vitasam/AppleII-VGA/AppleVGA/AppleVGA.kicad_sch

## KiCad design AppleVGA/AppleVGA.kicad_sch (2024-08-16)

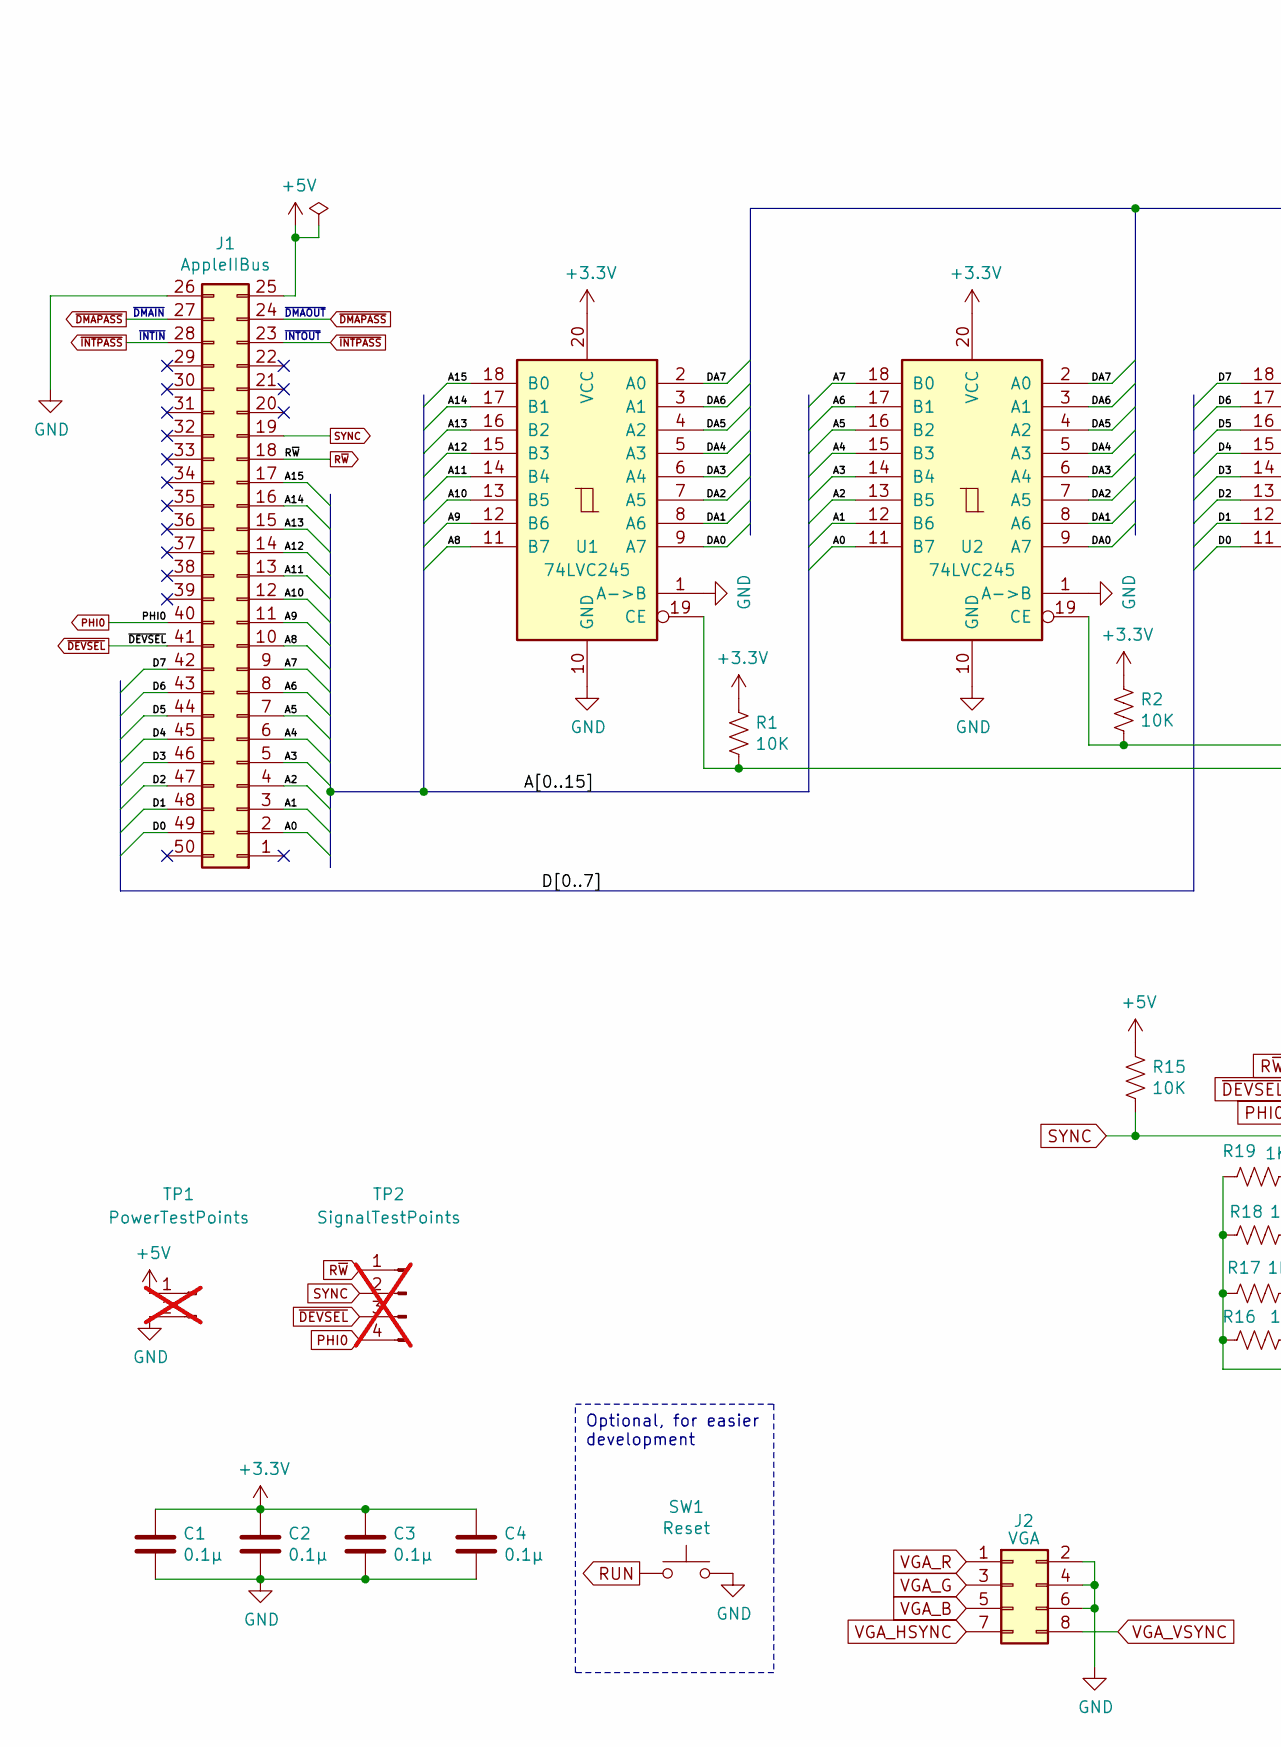
[picture p1: schematic AppleVGA.kicad_sch, part in row 1, column 1]

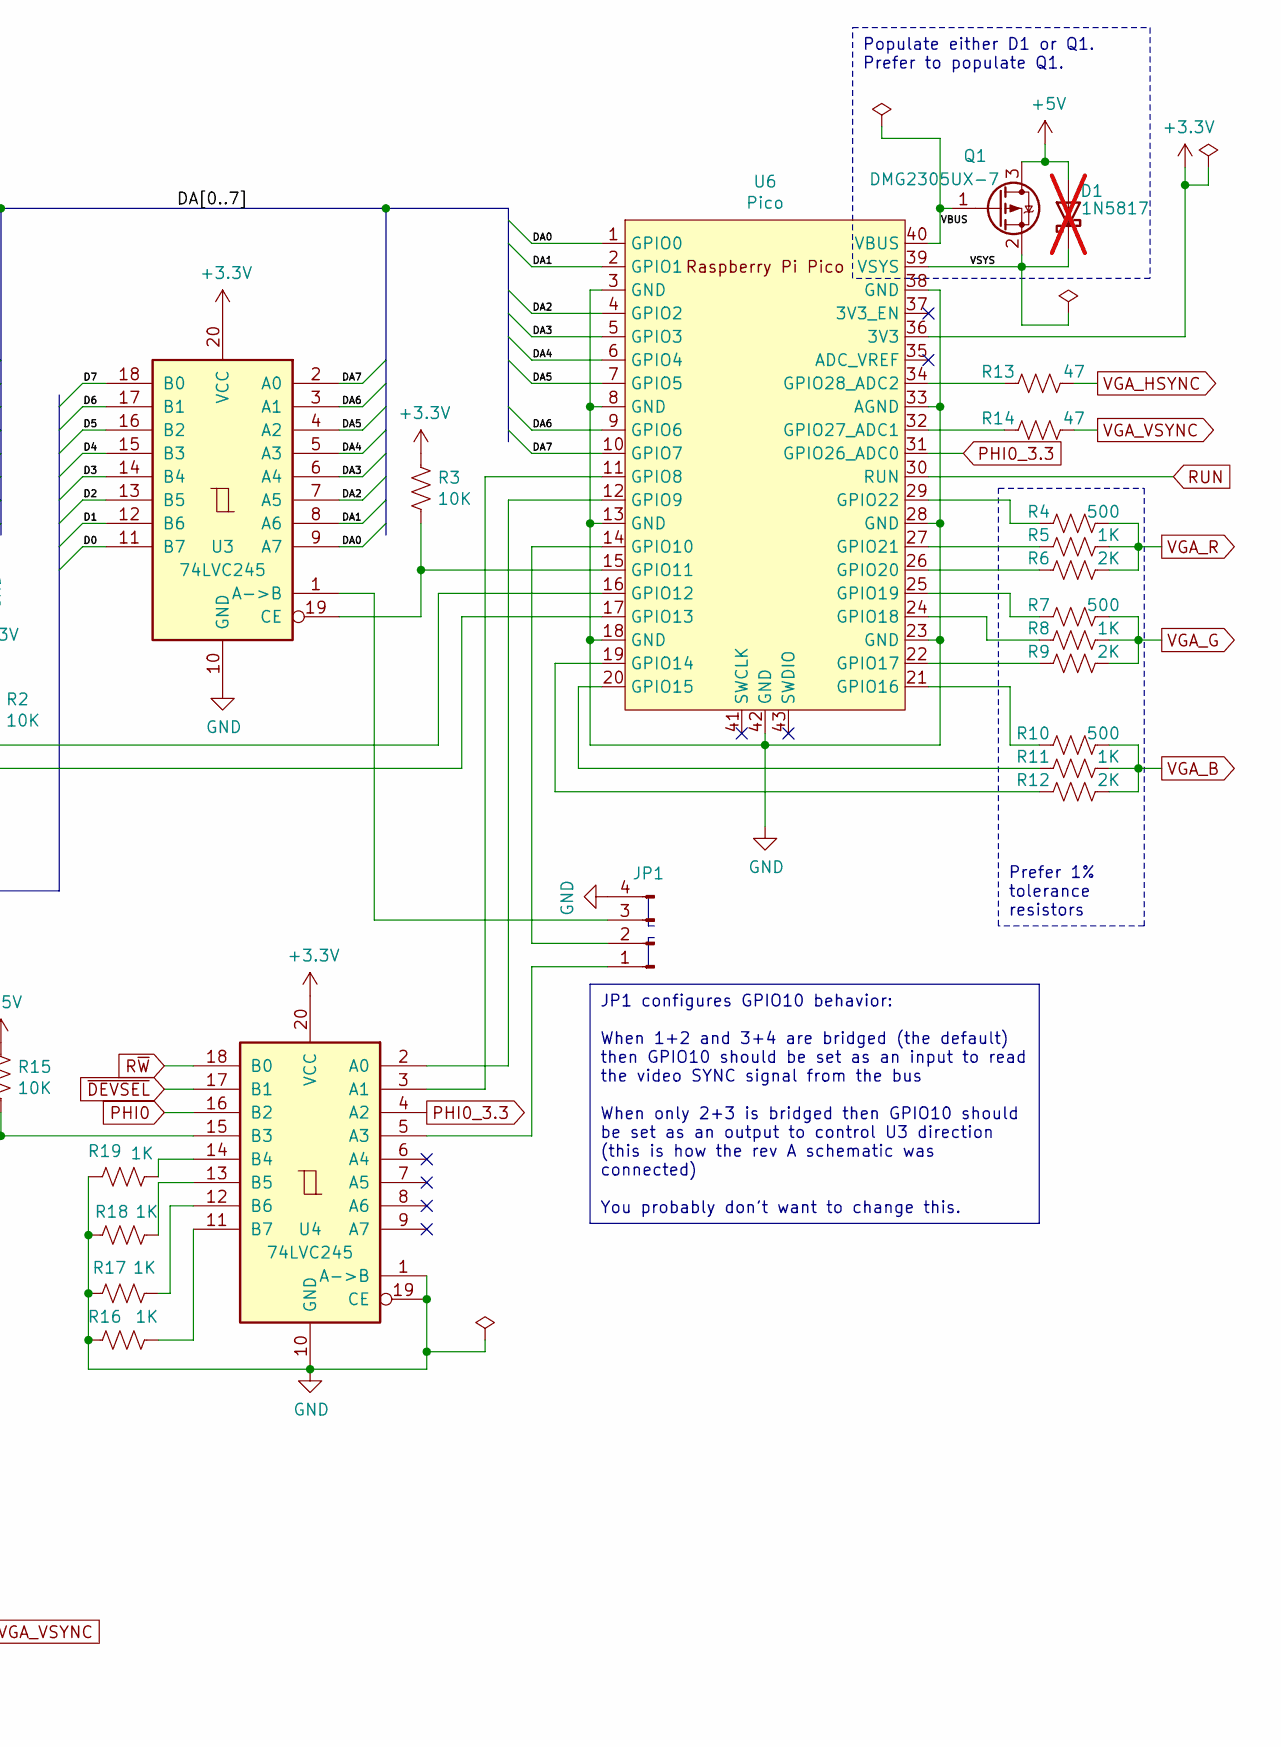
[picture p2: schematic AppleVGA.kicad_sch, part in row 1, column 2]

Parts:
C1, C2, C3, C4: 0.1μ; C_Disc_D4.3mm_W1.9mm_P5.00mm; MouserNo 594-A104K15X7RF5TAA
D1: 1N5817; D_DO-41_SOD81_P10.16mm_Horizontal; MouserNo 511-1N5817; not fitted
J1: AppleIIBus; AppleIIBus_Edge
J2: VGA; IDC-Header_2x04_P2.54mm_Vertical; MouserNo 649-75869-232LF
JP1: JumperPads; SolderJumper-4_P1.3mm_Bridged12_34_RoundedPad1.0x1.5mm_Numb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
Q1: DMG2305UX-7; SOT-23; MouserNo 621-DMG2305UX-7
R1, R2, R3, R15: 10K; R_Axial_DIN0207_L6.3mm_D2.5mm_P10.16mm_Thin_Horizontal; MouserNo 603-CFR-25JR-5210K
R4, R7, R10: 500; R_Axial_DIN0207_L6.3mm_D2.5mm_P10.16mm_Thin_Horizontal; MouserNo 603-MFR-25FBF52-499R
R5, R8, R11: 1K; R_Axial_DIN0207_L6.3mm_D2.5mm_P10.16mm_Thin_Horizontal; MouserNo 603-MFR-25FBF52-1K
R6, R9, R12: 2K; R_Axial_DIN0207_L6.3mm_D2.5mm_P10.16mm_Thin_Horizontal; MouserNo 603-MFR-25FBF52-2K
R13, R14: 47; R_Axial_DIN0207_L6.3mm_D2.5mm_P10.16mm_Thin_Horizontal; MouserNo 603-MFR-25FTF52-47R
R16, R17, R18, R19: 1K
SW1: Reset; SW_PUSH_6mm_H5mm; MouserNo 506-FSM4JH
TP1: PowerTestPoints; PinHeader_1x02_P2.54mm_Vertical; not fitted
TP2: SignalTestPoints; PinHeader_1x04_P2.54mm_Vertical; not fitted
U1, U2, U3, U4: 74LVC245; DIP-20_W7.62mm_Socket; MouserNo 595-SN74LVC245AN
U6: Pico; RPi_Pico_SMD_TH

Connections:
+3.3V: C1.1, C2.1, C3.1, C4.1, R1.1, R2.1, R3.1, U1.20 (VCC), U2.20 (VCC), U3.20 (VCC), U4.20 (VCC), U6.36 (3V3)
+5V: D1.2 (A), J1.25, Q1.3 (D), R15.1, TP1.1
A0: J1.2, U2.11 (B7)
A1: J1.3, U2.12 (B6)
A2: J1.4, U2.13 (B5)
A3: J1.5, U2.14 (B4)
A4: J1.6, U2.15 (B3)
A5: J1.7, U2.16 (B2)
A6: J1.8, U2.17 (B1)
A7: J1.9, U2.18 (B0)
A8: J1.10, U1.11 (B7)
A9: J1.11, U1.12 (B6)
A10: J1.12, U1.13 (B5)
A11: J1.13, U1.14 (B4)
A12: J1.14, U1.15 (B3)
A13: J1.15, U1.16 (B2)
A14: J1.16, U1.17 (B1)
A15: J1.17, U1.18 (B0)
D0: J1.49, U3.11 (B7)
D1: J1.48, U3.12 (B6)
D2: J1.47, U3.13 (B5)
D3: J1.46, U3.14 (B4)
D4: J1.45, U3.15 (B3)
D5: J1.44, U3.16 (B2)
D6: J1.43, U3.17 (B1)
D7: J1.42, U3.18 (B0)
DA0: U1.9 (A7), U2.9 (A7), U3.9 (A7), U6.1 (GPIO0)
DA1: U1.8 (A6), U2.8 (A6), U3.8 (A6), U6.2 (GPIO1)
DA2: U1.7 (A5), U2.7 (A5), U3.7 (A5), U6.4 (GPIO2)
DA3: U1.6 (A4), U2.6 (A4), U3.6 (A4), U6.5 (GPIO3)
DA4: U1.5 (A3), U2.5 (A3), U3.5 (A3), U6.6 (GPIO4)
DA5: U1.4 (A2), U2.4 (A2), U3.4 (A2), U6.7 (GPIO5)
DA6: U1.3 (A1), U2.3 (A1), U3.3 (A1), U6.9 (GPIO6)
DA7: U1.2 (A0), U2.2 (A0), U3.2 (A0), U6.10 (GPIO7)
GND: C1.2, C2.2, C3.2, C4.2, J1.26, J2.2, J2.4, J2.6, JP1.4, R16.1, R17.1, R18.1, R19.1, SW1.2, TP1.2, U1.1 (A->B), U1.10 (GND), U2.1 (A->B), U2.10 (GND), U3.10 (GND), U4.1 (A->B), U4.10 (GND), U4.19 (CE), U6.3 (GND), U6.8 (GND), U6.13 (GND), U6.18 (GND), U6.23 (GND), U6.28 (GND), U6.33 (AGND), U6.38 (GND), U6.42 (GND)
unnamed: JP1.1, U4.5 (A3)
unnamed: JP1.2, U6.14 (GPIO10)
unnamed: JP1.3, U3.1 (A->B)
unnamed: R1.2, U1.19 (CE), U6.17 (GPIO13)
unnamed: R2.2, U2.19 (CE), U6.16 (GPIO12)
unnamed: R3.2, U3.19 (CE), U6.15 (GPIO11)
unnamed: R4.1, U6.29 (GPIO22)
unnamed: R5.1, U6.27 (GPIO21)
unnamed: R6.1, U6.26 (GPIO20)
unnamed: R7.1, U6.25 (GPIO19)
unnamed: R8.1, U6.24 (GPIO18)
unnamed: R9.1, U6.22 (GPIO17)
unnamed: R10.1, U6.21 (GPIO16)
unnamed: R11.1, U6.20 (GPIO15)
unnamed: R12.1, U6.19 (GPIO14)
unnamed: R13.1, U6.34 (GPIO28_ADC2)
unnamed: R14.1, U6.32 (GPIO27_ADC1)
unnamed: R16.2, U4.11 (B7)
unnamed: R17.2, U4.12 (B6)
unnamed: R18.2, U4.13 (B5)
unnamed: R19.2, U4.14 (B4)
unnamed: U4.2 (A0), U6.12 (GPIO9)
unnamed: U4.3 (A1), U6.11 (GPIO8)
PHI0: J1.40, TP2.4, U4.16 (B2)
PHI0_3.3: U4.4 (A2), U6.31 (GPIO26_ADC0)
RUN: SW1.1, U6.30 (RUN)
R~W: J1.18, TP2.1, U4.18 (B0)
SYNC: J1.19, R15.2, TP2.2, U4.15 (B3)
VBUS: Q1.1 (G), U6.40 (VBUS)
VGA_B: J2.5, R10.2, R11.2, R12.2
VGA_G: J2.3, R7.2, R8.2, R9.2
VGA_HSYNC: J2.7, R13.2
VGA_R: J2.1, R4.2, R5.2, R6.2
VGA_VSYNC: J2.8, R14.2
VSYS: D1.1 (K), Q1.2 (S), U6.39 (VSYS)
~DEVSEL: J1.41, TP2.3, U4.17 (B1)
~DMAPASS: J1.24, J1.27
~INTPASS: J1.23, J1.28

Notes on the sheet:
Optional, for easier development
Populate either D1 or Q1. Prefer to populate Q1.
JP1 configures GPIO10 behavior: When 1+2 and 3+4 are bridged (the default) then GPIO10 should be set as an input to read the video SYNC signal from the bus When only 2+3 is bridged then GPIO10 should be set as an output to control U3 direction (this is how the rev A schematic was connected) You pro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
Prefer 1% tolerance resistors
~{DMAIN}
~{INTOUT}
~{DMAOUT}
~{INTIN}
